galloj/smart_lamp/imgs/lamp_finnished.jpg

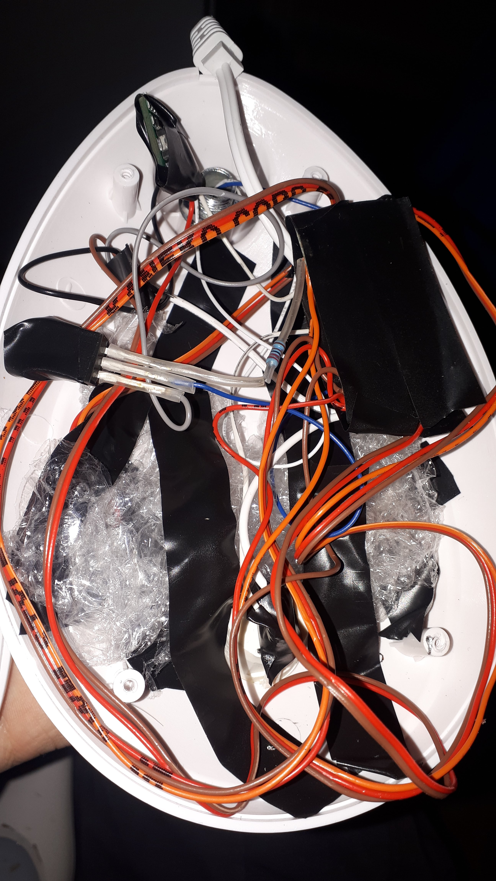
imgs/lamp_finnished.jpg
