galloj/smart_lamp/imgs/screw_pad.jpg

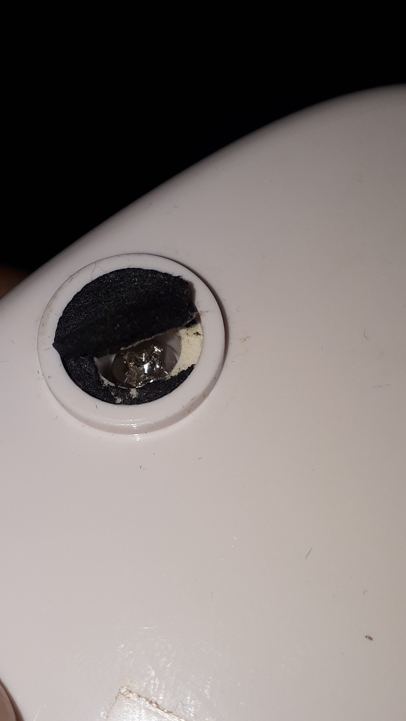
imgs/screw_pad.jpg
