galloj/smart_lamp/imgs/transistor.jpg

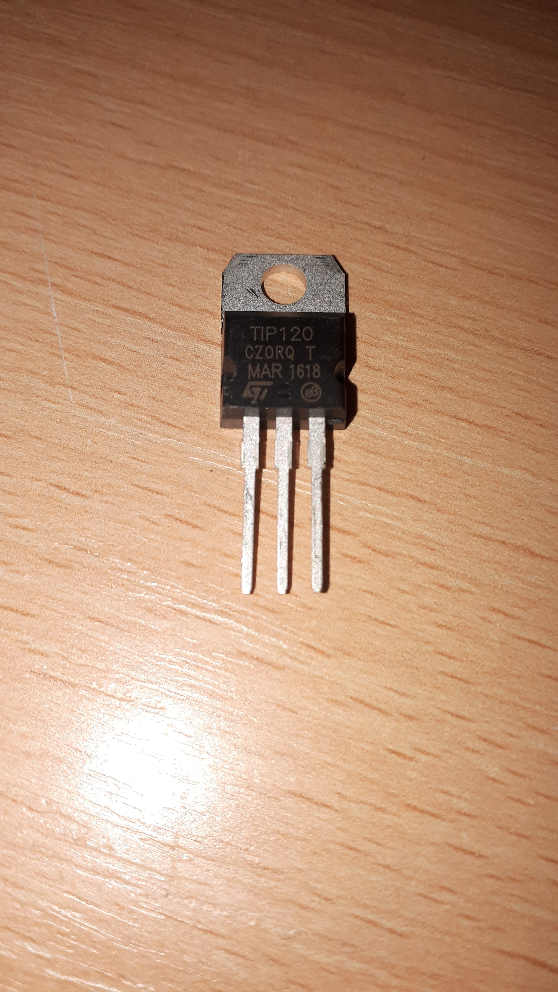
imgs/transistor.jpg
